judyta-ferenc/Yagi-Uda-868MHz-Antenna/README.md

# 3D-Printed Yagi-Uda Antenna for 868 MHz

This directional Yagi-Uda antenna was designed, simulated, and constructed as a key technical component of an educational radio-localization field game titled **"Fox Hunting"**.

### 1. Antenna Dimensions
The geometry was calculated using the **DL6WU** algorithm and then optimized in **CST Studio** for the 868 MHz LoRa receiver.
* **Center Frequency:** 868 MHz ($\lambda = 345\text{ mm}$)
* **Total Elements:** 7 elements, including 1 reflector, 1 dipole, and 5 directors
* **Boom Length:** 416 mm (compact for handheld field use).
* **Element Diameter:** 2 mm round copper wire.

*Full dimensions are stored in the `data/antenna_dimensions.txt` file.*

### 2. CST Simulation
The antenna was modeled and simulated in **CST Microwave Studio** to verify its performance before manufacturing.

* **Gain:** $12.06\text{ dBi}$
* **3 dB Angular Width:** $44.9^\circ$
* **Side Lobe Level:** $-21.7\text{ dB}$
* **$S_{11}$ (at 868 MHz):** $-16.99\text{ dB}$

#### Antenna Model in CST:
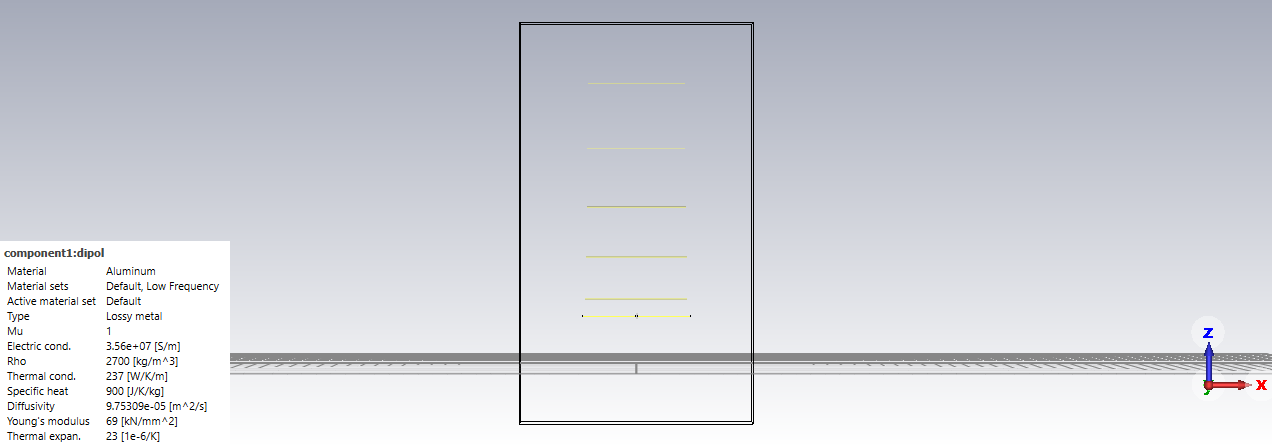
[picture p1: screenshots/cst_model.png]
CST Model


#### Farfield Radiation Pattern (2D Polar Plot):
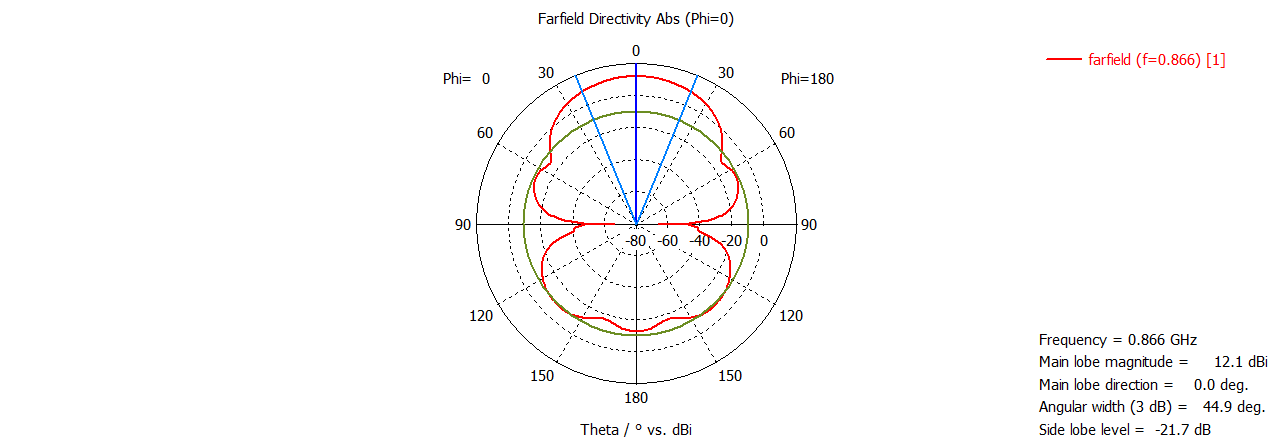
[picture p2: screenshots/farfield_2d.png]
Farfield 2D


#### 3D Radiation Pattern:
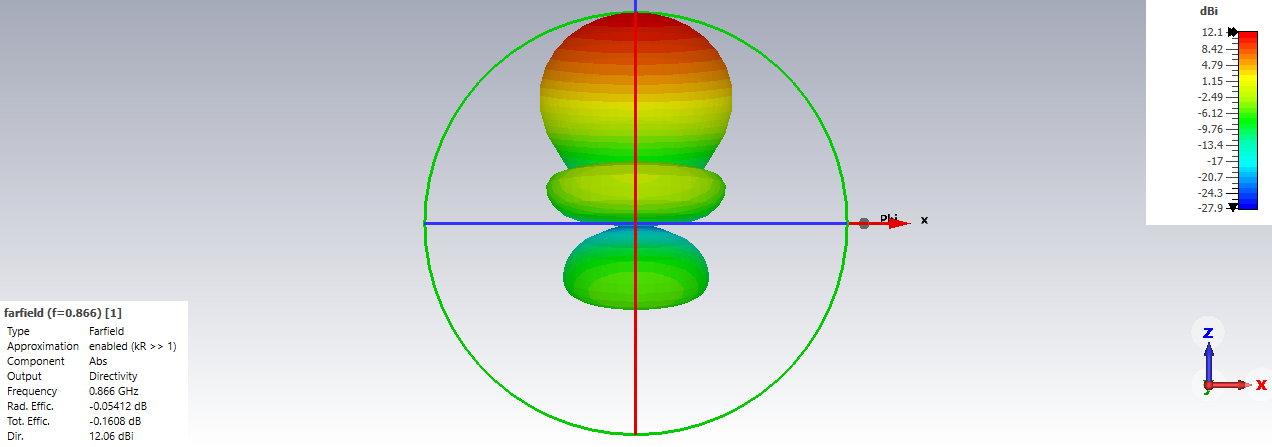
[picture p3: screenshots/farfield_3d.png]
Farfield 3D


#### Simulated $S_{11}$ Return Loss:
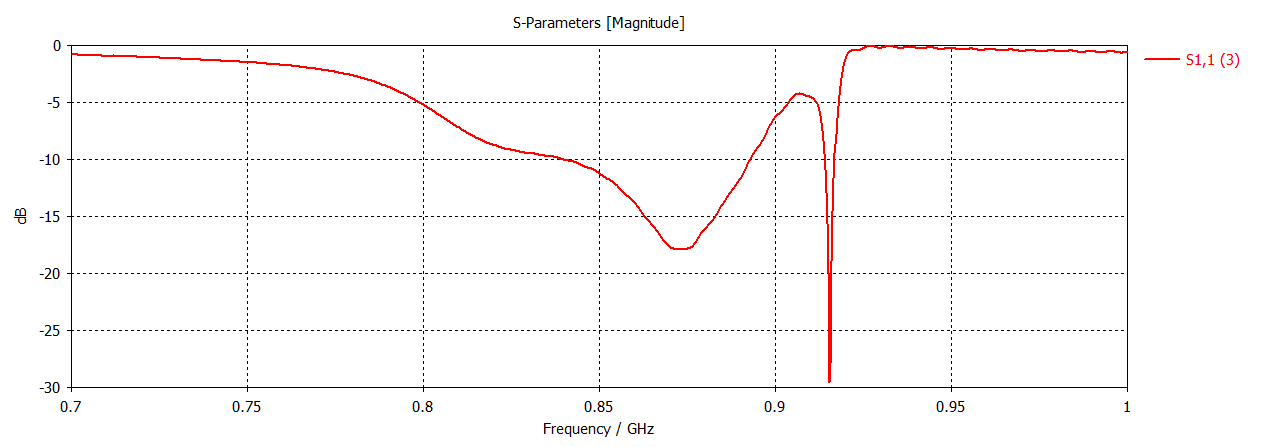
[picture p4: screenshots/s11_simulation.png]
S11 Plot


### 3. Final Construction
* **Boom & Handle:** 3D-printed to create a simple, non-conductive, and lightweight structure, making it comfortable to hold and carry during the "Fox Hunting" field game.
* **Elements:** Made from copper wire with an exact 2 mm diameter, precision-cut to the calculated lengths and pressed directly into the 3D-printed frame.

#### Final 3D-Printed Antenna:
<p align="center">
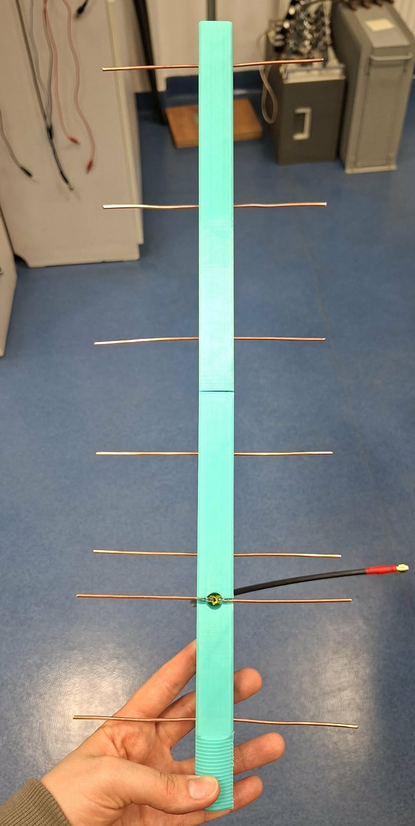
[picture p5: measurements/final_antenna.jpg]
Physical Antenna
  
</p>

### 4. VNA Measurements
The final antenna parameters were verified using a **Vector Network Analyzer (VNA)**:

* **Best Match Frequency (896 MHz):** **$-20.56\text{ dB}$**
* **Operating Frequency (868 MHz):** **$-16.44\text{ dB}$**
* **Result:** The antenna was tested with the rest of the system and works perfectly, providing a clear and reliable signal during the game.

#### Comparison of Simulated and Measured $S_{11}$ Return Loss:
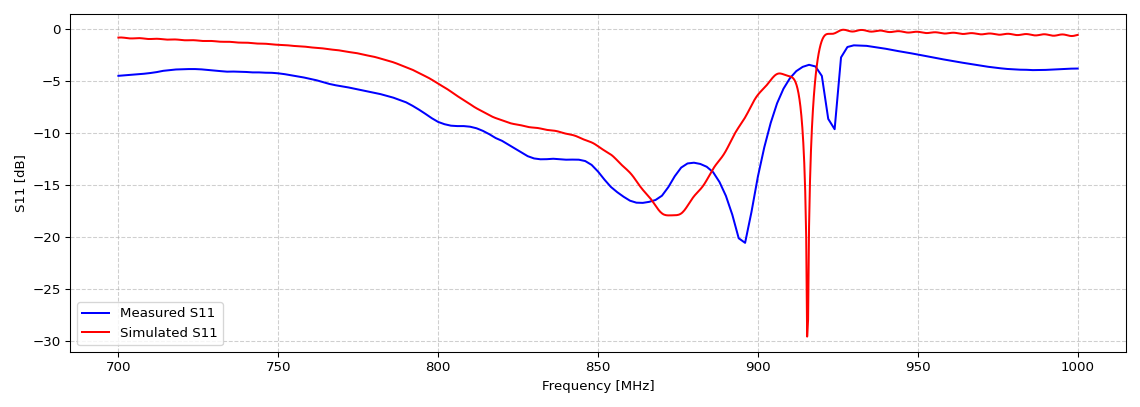
[picture p6: measurements/vna_s11_comparison.png]
VNA Measurement
